jtm1816/georgia-esp32-scoreboard/docs/board-dimensions.png

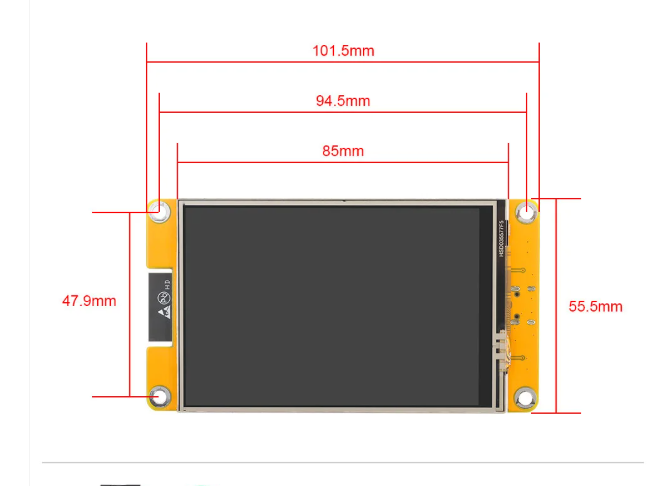
docs/board-dimensions.png
