jtm1816/georgia-esp32-scoreboard/case/front-bezel-with-lettering.stl

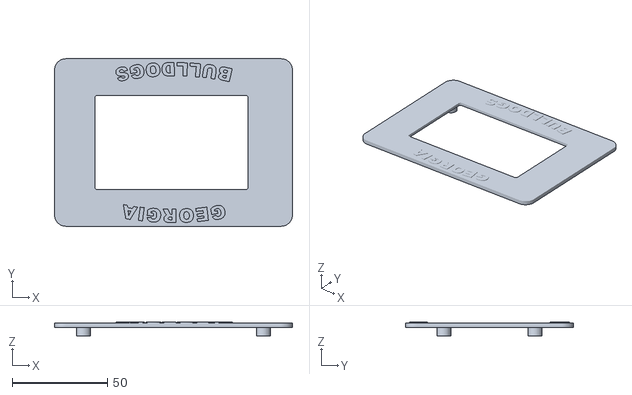
[picture p4: CAD file, 2026-11-13]
case/front-bezel-with-lettering.stl
125.0 x 88.0 x 7.40
