jtm1816/georgia-esp32-scoreboard/case/rear-shell-and-stand.stl

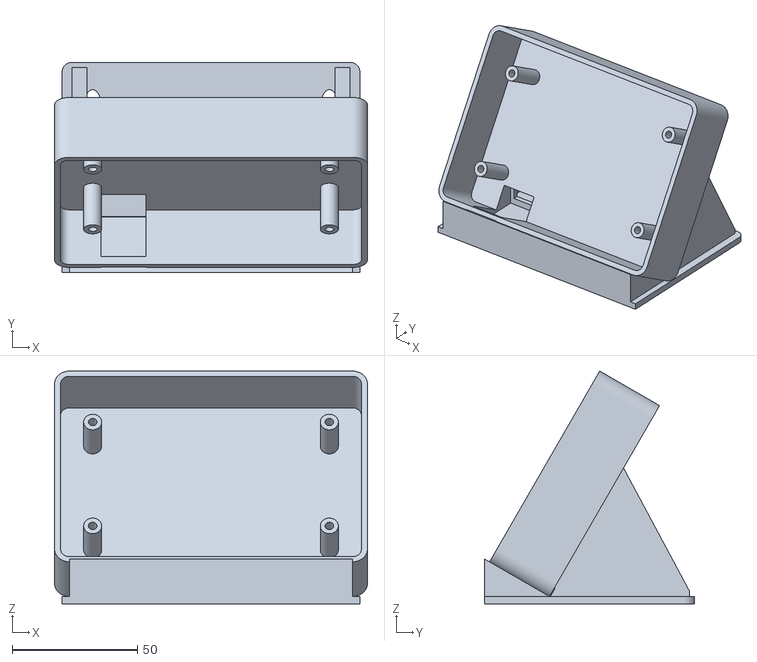
[picture p5: CAD file, 2026-11-10]
case/rear-shell-and-stand.stl
125.0 x 84.0 x 93.0
