jtm1816/georgia-esp32-scoreboard/docs/build-verification.txt

0900.250804 (4.9.0) 
 - toolchain-xtensa-esp32 @ 8.4.0+2021r2-patch5
LDF: Library Dependency Finder -> https://bit.ly/configure-pio-ldf
LDF Modes: Finder ~ chain, Compatibility ~ soft
Found 37 compatible libraries
Scanning dependencies...
Dependency Graph
|-- TFT_eSPI @ 2.5.43
|-- XPT2046_Touchscreen @ 0.0.0+sha.d57f64c
|-- ArduinoJson @ 7.4.2
|-- WiFiManager @ 2.0.17
|-- HTTPClient @ 2.0.0
|-- Preferences @ 2.0.0
|-- WiFi @ 2.0.0
|-- WiFiClientSecure @ 2.0.0
Building in release mode
Compiling .pio\build\esp32_035\src\main.cpp.o
In file included from src/main.cpp:7:
.pio/libdeps/esp32_035/TFT_eSPI/TFT_eSPI.h:973:8: warning: #warning >>>>------>> TOUCH_CS pin not defined, TFT_eSPI touch functions will not be available! [-Wcpp]
       #warning >>>>------>> TOUCH_CS pin not defined, TFT_eSPI touch functions will not be available!
        ^~~~~~~
Linking .pio\build\esp32_035\firmware.elf
Retrieving maximum program size .pio\build\esp32_035\firmware.elf
Checking size .pio\build\esp32_035\firmware.elf
Advanced Memory Usage is available via "PlatformIO Home > Project Inspect"
RAM:   [==        ]  15.5% (used 50768 bytes from 327680 bytes)
Flash: [======    ]  58.8% (used 1155969 bytes from 1966080 bytes)
Building .pio\build\esp32_035\firmware.bin with action:
  "$PYTHONEXE" "$OBJCOPY" --chip esp32 elf2image --flash_mode ${__get_board_flash_mode(__env__)} --flash_freq ${__get_board_f_image(__env__)} --flash_size 4MB --elf-sha256-offset 0xb0 -o $TARGET $SOURCES
Building .pio\build\esp32_035\firmware.bin
esptool.py v4.9.0
Creating esp32 image...
Merged 27 ELF sections
Successfully created esp32 image.
========================= [SUCCESS] Took 19.44 seconds =========================
