jtm1816/georgia-esp32-scoreboard/src/main.cpp

#include <Arduino.h>
#include <WiFi.h>
#include <WiFiClientSecure.h>
#include <HTTPClient.h>
#include <WiFiManager.h>
#include <Preferences.h>
#include <TFT_eSPI.h>
#include <XPT2046_Touchscreen.h>
#include <ArduinoJson.h>
#include <time.h>
#include <algorithm>
#include <vector>
#include <functional>
#include "georgia_logo.h"
#include "feed_ca.h"

// ESP32-035: 480x320 TFT and XPT2046 on the same HSPI bus.
// A fixed 16-color palette keeps the 480x320 frame at 76,800 bytes.
constexpr uint16_t BG=0,WHITE=1,DAWGS_RED=2,MUTED=3,GOLD=4;
const uint16_t PALETTE[16]={0x0841,0xffff,0xb865,0xbdf7,0xf66c,0xa285,0xfbe0,0x4208,0xf34c,0x2104,0x0000,0x8000,0xc800,0xf000,0x8410,0xd6ba};
const char* PATHS[]={"football/college-football","basketball/mens-college-basketball","baseball/college-baseball"};
const char* TITLES[]={"FOOTBALL","MEN'S BASKETBALL","BASEBALL"};
const char* IDS[]={"61","61","78"};
TFT_eSPI tft;
TFT_eSprite screen(&tft);
XPT2046_Touchscreen touch(33,36);
constexpr int DISPLAY_W=480,DISPLAY_H=320;
int calX1=300,calY1=300,calX2=3700,calY2=3700;
Preferences prefs;
SemaphoreHandle_t modelMutex;
volatile int selectedSport=0;
volatile bool manualSport=false, forceRefresh=true;
volatile uint32_t revision=0;
String serialLine;
bool scheduleView=false;
uint32_t scheduleUntil=0, viewSince=0;

void configurePanel(){
  pinMode(33,OUTPUT);digitalWrite(33,HIGH);
  tft.init();tft.setRotation(3);tft.invertDisplay(prefs.getBool("035inv",false));
  pinMode(27,OUTPUT);digitalWrite(27,HIGH);tft.fillScreen(BG);
  Serial.printf("PANEL ESP32-035 %dx%d ID04=%08lx IDD3=%08lx\n",tft.width(),tft.height(),tft.readcommand32(0x04),tft.readcommand32(0xd3));
}
void present(){screen.pushSprite(0,0);}
void drawLogo(int x,int y){
  for(int py=0;py<32;py++)for(int px=0;px<46;px++){
    uint16_t value=pgm_read_word(GEORGIA_LOGO+py*46+px);int best=0,bestDistance=INT_MAX;
    for(int i=0;i<16;i++){
      int dr=int((value>>11)&31)-int((PALETTE[i]>>11)&31);
      int dg=int((value>>5)&63)-int((PALETTE[i]>>5)&63);
      int db=int(value&31)-int(PALETTE[i]&31);int distance=dr*dr*4+dg*dg+db*db*4;
      if(distance<bestDistance){bestDistance=distance;best=i;}
    }
    screen.drawPixel(x+px,y+py,best);
  }
}

class CooperativeStream:public Stream{
  Stream& input;uint32_t bytes=0;
public:
  explicit CooperativeStream(Stream& s):input(s){setTimeout(20000);}
  int available()override{return input.available();}
  int peek()override{uint32_t start=millis();int v;while((v=input.peek())<0&&millis()-start<15000)delay(1);return v;}
  void flush()override{}
  size_t write(uint8_t)override{return 0;}
  int read()override{
    uint32_t start=millis();int v;
    while((v=input.read())<0&&millis()-start<15000)delay(1);
    if((++bytes&511)==0)delay(1);
    return v;
  }
};

struct Upcoming { String opponent,date,venue,city; bool home=false,neutral=false,tbd=false; };
struct Game {
  String id, date, opponent="OPPONENT", venue, city, state="", status="Loading...", detail;
  String lastPlay="Waiting for game data", score[2]={"-","-"}, bonus[2];
  String homeId, awayId;
  int timeouts[2]={-1,-1}, timeoutSlots=3, possession=-1, balls=-1,strikes=-1,outs=-1;
  bool first=false,second=false,third=false, live=false, loaded=false, error=false;
  uint32_t updated=0;
  Upcoming next[3]; int nextCount=0;
};
Game models[3];

String str(JsonVariantConst v, const char* fallback="") {
  if(v.is<const char*>()) return String(v.as<const char*>());
  if(v.is<int>()) return String(v.as<int>());
  if(v.is<float>()) return String(v.as<float>(),0);
  return String(fallback);
}
String ascii(String s) {
  s.replace("’","'"); s.replace("–","-"); s.replace("—","-"); s.replace("•","|");
  String out; out.reserve(s.length());
  for(size_t i=0;i<s.length();i++) if((uint8_t)s[i]>=32&&(uint8_t)s[i]<127) out+=s[i];
  return out;
}
time_t epoch(String iso) {
  int y,m,d,h=0,min=0;
  if(sscanf(iso.c_str(),"%d-%d-%dT%d:%d",&y,&m,&d,&h,&min)<3) return 0;
  y-=m<=2;int era=(y>=0?y:y-399)/400;unsigned yoe=y-era*400;
  unsigned doy=(153*(m+(m>2?-3:9))+2)/5+d-1;
  unsigned doe=yoe*365+yoe/4-yoe/100+doy;
  return (int64_t(era)*146097+doe-719468)*86400+h*3600+min*60;
}
String localDate(String iso,bool tbd=false) {
  time_t ts=epoch(iso); if(!ts) return "Date TBD";
  struct tm t;localtime_r(&ts,&t);char buf[48];
  strftime(buf,sizeof(buf),tbd?"%a %b %d | TBD":"%a %b %d | %I:%M %p ET",&t);
  return String(buf);
}

bool getJson(const String& url, JsonDocument& output, JsonDocument& filter) {
  WiFiClientSecure tls;tls.setCACert(FEED_CA);tls.setTimeout(15);
  HTTPClient http; http.useHTTP10(true);http.setConnectTimeout(12000);http.setTimeout(15000);
  if(!http.begin(tls,url)) return false;
  http.addHeader("Accept","application/json");http.addHeader("User-Agent","GeorgiaDeskDashboard/1.0");
  http.addHeader("Accept-Encoding","identity");
  int code=http.GET();
  if(code!=200){Serial.printf("FEED_HTTP %d\n",code);http.end();return false;}
  CooperativeStream response(http.getStream());
  auto err=deserializeJson(output,response,DeserializationOption::Filter(filter),DeserializationOption::NestingLimit(40));
  http.end();
  if(err){Serial.printf("FEED_JSON %s\n",err.c_str());return false;}
  return true;
}

// Parse a large feed array incrementally; never retain a whole day's games.
bool walkArray(const String& url,const char* key,JsonDocument& filter,std::function<bool(JsonVariantConst)> visit){
  WiFiClientSecure tls;tls.setCACert(FEED_CA);tls.setTimeout(20);
  HTTPClient http;http.useHTTP10(true);http.setConnectTimeout(12000);http.setTimeout(20000);
  if(!http.begin(tls,url))return false;
  http.addHeader("Accept-Encoding","identity");http.addHeader("User-Agent","GeorgiaDeskDashboard/1.1");
  int code=http.GET();if(code!=200){Serial.printf("ARRAY_HTTP %d\n",code);http.end();return false;}
  CooperativeStream stream(http.getStream());String token=String("\"")+key+"\"";
  if(!stream.find(token.c_str())||!stream.find("[")){http.end();return false;}
  bool ok=true;JsonDocument item;
  for(;;){
    int ch=stream.peek();while(ch==' '||ch=='\r'||ch=='\n'||ch=='\t'||ch==','){stream.read();ch=stream.peek();}
    if(ch==']')break;
    if(ch!='{'){ok=false;break;}
    auto err=deserializeJson(item,stream,DeserializationOption::Filter(filter),DeserializationOption::NestingLimit(40));
    if(err){Serial.printf("ARRAY_JSON %s\n",err.c_str());ok=false;break;}
    if(!visit(item.as<JsonVariantConst>()))break;
    item.clear();delay(1);
  }
  http.end();return ok;
}

void eventFilter(JsonObject v) {
  v["id"]=true;v["date"]=true;v["status"]=true;
  JsonObject c=v["competitions"][0].to<JsonObject>();c["id"]=true;c["date"]=true;c["dateValid"]=true;
  c["status"]=true;c["venue"]=true;c["neutralSite"]=true;c["situation"]=true;
  JsonObject t=c["competitors"][0].to<JsonObject>();
  t["id"]=true;t["homeAway"]=true;t["score"]=true;t["possession"]=true;
  t["timeoutsRemaining"]=true;t["bonus"]=true;t["doubleBonus"]=true;
  t["team"]["id"]=true;t["team"]["shortDisplayName"]=true;
  t["team"]["displayName"]=true;t["team"]["abbreviation"]=true;
}
void location(JsonVariantConst venue, String& name,String& city) {
  name=ascii(str(venue["fullName"]));
  city=ascii(str(venue["address"]["city"]));
  String region=str(venue["address"]["state"]);
  if(region.length())city+=(city.length()?", ":"")+region;
}
int teamIndex(String id,int sport) {return id==IDS[sport]?0:1;}
void readEvent(JsonVariantConst e,Game& g,int sport) {
  auto c=e["competitions"][0];
  g.id=str(e["id"]);g.date=str(e["date"]);
  auto status=e["status"].isNull()?c["status"]:e["status"];
  g.state=str(status["type"]["state"]);g.live=g.state=="in";
  g.status=ascii(str(status["type"]["shortDetail"],"Scheduled"));
  if(g.state=="pre")g.status=localDate(g.date,c["dateValid"]==false);
  location(c["venue"],g.venue,g.city);
  g.possession=-1;g.timeouts[0]=g.timeouts[1]=-1;g.bonus[0]=g.bonus[1]="";
  g.balls=g.strikes=g.outs=-1;g.first=g.second=g.third=false;
  g.timeoutSlots=sport==0?3:4;
  for(auto t:c["competitors"].as<JsonArrayConst>()) {
    String id=str(t["id"]);if(!id.length())id=str(t["team"]["id"]);
    int n=teamIndex(id,sport);
    if(n==1)g.opponent=ascii(str(t["team"]["shortDisplayName"],str(t["team"]["displayName"],"Opponent").c_str()));
    if(str(t["homeAway"])=="home")g.homeId=id;else g.awayId=id;
    g.score[n]=str(t["score"]["displayValue"]);
    if(!g.score[n].length())g.score[n]=str(t["score"],"-");
    if(g.state=="pre")g.score[n]="-";
    if(g.live&&t["possession"]==true)g.possession=n;
    if(g.live&&t["timeoutsRemaining"].is<int>())g.timeouts[n]=t["timeoutsRemaining"];
    if(g.live&&t["doubleBonus"]==true)g.bonus[n]="DOUBLE BONUS";
    else if(g.live&&t["bonus"]==true)g.bonus[n]="BONUS";
  }
  auto sit=c["situation"];
  g.detail=ascii(str(sit["downDistanceText"]));
  if(g.live&&!sit.isNull()) {
    String poss=str(sit["possession"]);
    if(poss.length())g.possession=teamIndex(poss,sport);
    if(sport==2){
      if(sit["balls"].is<int>())g.balls=sit["balls"];
      if(sit["strikes"].is<int>())g.strikes=sit["strikes"];
      if(sit["outs"].is<int>())g.outs=sit["outs"];
      g.first=sit["onFirst"]|false;g.second=sit["onSecond"]|false;g.third=sit["onThird"]|false;
      String prefix=str(status["periodPrefix"]);String low=g.status;low.toLowerCase();
      if(g.possession<0&&(prefix=="Top"||low.indexOf("top")>=0))g.possession=teamIndex(g.awayId,sport);
      if(g.possession<0&&(prefix=="Bottom"||low.indexOf("bot")>=0))g.possession=teamIndex(g.homeId,sport);
      g.detail=g.first||g.second||g.third?String(g.first?"1B ":"")+String(g.second?"2B ":"")+String(g.third?"3B ":"")+"occupied":"Bases empty";
    }
  }
  g.loaded=true;
}

bool fetchSchedule(int sport,Game& result) {
  JsonDocument filter;eventFilter(filter.to<JsonObject>());
  String url=String("https://site.api.espn.com/apis/site/v2/sports/")+PATHS[sport]+"/teams/"+IDS[sport]+"/schedule";
  time_t now=time(nullptr),lastTime=0,soon=LONG_MAX;Game live,last,upcoming;bool haveLive=false,haveLast=false,haveNext=false;int count=0;
  std::vector<Upcoming> next;
  auto visitor=[&](JsonVariantConst e){
    count++;
    auto c=e["competitions"][0];auto st=e["status"].isNull()?c["status"]:e["status"];
    String state=str(st["type"]["state"]);time_t ts=epoch(str(e["date"]));
    if(state=="in"){readEvent(e,live,sport);haveLive=true;}
    if(state=="post"&&ts>lastTime){lastTime=ts;readEvent(e,last,sport);haveLast=true;}
    if(state=="pre"&&ts>now-86400){
      Game temp;readEvent(e,temp,sport);if(ts<soon){soon=ts;upcoming=temp;haveNext=true;}
      Upcoming u;u.date=temp.date;u.opponent=temp.opponent;u.venue=temp.venue;u.city=temp.city;
      u.tbd=c["dateValid"]==false;u.neutral=c["neutralSite"]|false;
      u.home=temp.homeId==IDS[sport];next.push_back(u);
      std::sort(next.begin(),next.end(),[](const Upcoming& a,const Upcoming& b){return a.date<b.date;});
      if(next.size()>3)next.pop_back();
    }
    return true;
  };
  if(!walkArray(url,"events",filter,visitor))return false;
  if(!count){struct tm t;localtime_r(&now,&t);String season=String(t.tm_year+1900+(sport==1&&t.tm_mon>=6?1:0));if(!walkArray(url+"?season="+season,"events",filter,visitor))return false;}
  String previousId=result.id,previousPlay=result.lastPlay;
  if(haveLive)result=live;else if(haveLast&&now-lastTime<18*3600)result=last;else if(haveNext)result=upcoming;else if(haveLast)result=last;
  else {result=Game();result.loaded=true;result.status="Schedule unavailable";result.lastPlay="No published games found";}
  if(result.id==previousId&&previousId.length())result.lastPlay=previousPlay;
  result.nextCount=next.size();for(int i=0;i<result.nextCount;i++)result.next[i]=next[i];
  return true;
}
String latestPlay(JsonVariantConst plays) {
  String found;
  for(auto p:plays.as<JsonArrayConst>()){
    String txt=ascii(str(p["text"]));String low=txt;low.toLowerCase();
    if(txt.length()&&low.indexOf("end of")==-1&&low!="end game")found=txt;
  }
  return found;
}
void summaryFilter(JsonDocument& f) {
  f["gameInfo"]["venue"]=true;
  JsonObject p=f["plays"][0].to<JsonObject>();p["text"]=true;p["type"]=true;p["team"]["id"]=true;
  p["participants"][0]["athlete"]["displayName"]=true;
  f["drives"]["current"]["plays"][0]["text"]=true;
  f["drives"]["previous"][0]["plays"][0]["text"]=true;
  f["atBats"][0]["text"]=true;
}
String timeoutLabel(String text,String teamId,Game& g,int sport){
  String low=text;low.toLowerCase();
  if(low.indexOf("timeout")<0&&low.indexOf("time out")<0)return text;
  if(low.indexOf("media")>=0||low.indexOf("official")>=0||low.indexOf("tv timeout")>=0)return "TIMEOUT - OFFICIAL";
  if(teamId.length())return "TIMEOUT - "+(teamIndex(teamId,sport)==0?String("GEORGIA"):g.opponent);
  String opp=g.opponent;opp.toLowerCase();
  if(low.indexOf("georgia")>=0||low.indexOf("uga")>=0)return "TIMEOUT - GEORGIA";
  if(opp.length()&&low.indexOf(opp)>=0)return "TIMEOUT - "+g.opponent;
  return "TIMEOUT";
}
bool fetchSummary(int sport,Game& g) {
  if(!g.id.length()||g.state=="pre"){g.lastPlay=g.state=="pre"?"Game has not started":"Play-by-play unavailable";return true;}
  JsonDocument f,doc;summaryFilter(f);
  String url=String("https://site.api.espn.com/apis/site/v2/sports/")+PATHS[sport]+"/summary?event="+g.id;
  if(sport==1){
    JsonDocument pf;pf["text"]=true;pf["team"]["id"]=true;
    String latest,team;
    bool ok=walkArray(url,"plays",pf,[&](JsonVariantConst p){String s=ascii(str(p["text"]));String low=s;low.toLowerCase();if(s.length()&&low.indexOf("end of")==-1){latest=s;team=str(p["team"]["id"]);}return true;});
    if(ok)g.lastPlay=latest.length()?timeoutLabel(latest,team,g,sport):"Play-by-play unavailable";
    return ok;
  }
  if(!getJson(url,doc,f))return false;
  if(!doc["gameInfo"]["venue"].isNull())location(doc["gameInfo"]["venue"],g.venue,g.city);
  String text=latestPlay(doc["plays"]),team;
  JsonVariantConst lastRelevant;
  for(auto p:doc["plays"].as<JsonArrayConst>())if(ascii(str(p["text"]))==text)lastRelevant=p;
  if(!lastRelevant.isNull())team=str(lastRelevant["team"]["id"]);
  if(!text.length())for(auto drive:doc["drives"]["previous"].as<JsonArrayConst>()){String s=latestPlay(drive["plays"]);if(s.length())text=s;}
  String current=latestPlay(doc["drives"]["current"]["plays"]);if(current.length())text=current;
  if(!text.length())text=latestPlay(doc["atBats"]);
  g.lastPlay=text.length()?timeoutLabel(text,team,g,sport):"Play-by-play unavailable";
  return true;
}
bool scoreboard(int sport,Game& g,bool& foundLive) {
  JsonDocument f;eventFilter(f.to<JsonObject>());
  time_t now=time(nullptr);struct tm t;localtime_r(&now,&t);char date[10];strftime(date,sizeof(date),"%Y%m%d",&t);
  String url=String("https://site.api.espn.com/apis/site/v2/sports/")+PATHS[sport]+"/scoreboard?limit=1000&dates="+date+(sport==0?"&groups=80":sport==1?"&groups=50":"");
  foundLive=false;
  return walkArray(url,"events",f,[&](JsonVariantConst e){
    bool uga=false;for(auto c:e["competitions"][0]["competitors"].as<JsonArrayConst>())if(str(c["id"])==IDS[sport])uga=true;
    if(!uga)return true;
    String state=str(e["status"]["type"]["state"]);
    if(state=="in"||str(e["id"])==g.id||state=="post"){
      readEvent(e,g,sport);foundLive=g.live;
      if(!e["competitions"][0]["situation"]["lastPlay"]["text"].isNull())
        g.lastPlay=timeoutLabel(ascii(str(e["competitions"][0]["situation"]["lastPlay"]["text"])),str(e["competitions"][0]["situation"]["lastPlay"]["team"]["id"]),g,sport);
      if(foundLive)return false;
    }
    return true;
  });
}
Game snapshot(int sport){xSemaphoreTake(modelMutex,portMAX_DELAY);Game g=models[sport];xSemaphoreGive(modelMutex);return g;}
void publish(int sport,const Game& g){xSemaphoreTake(modelMutex,portMAX_DELAY);models[sport]=g;revision++;xSemaphoreGive(modelMutex);}
void feedTask(void*){
  uint32_t scheduleAt[3]={},boardAt[3]={};int lastSelected=-1;
  for(;;){
    if(WiFi.status()!=WL_CONNECTED){vTaskDelay(pdMS_TO_TICKS(1000));continue;}
    if(time(nullptr)<1700000000){vTaskDelay(pdMS_TO_TICKS(1000));continue;}
    int active=selectedSport;bool force=forceRefresh||lastSelected!=active;forceRefresh=false;lastSelected=active;
    int livePriority=-1;
    for(int s=0;s<3;s++){
      Game g=snapshot(s);uint32_t now=millis();bool ok=true;
      if(!g.loaded||now-scheduleAt[s]>900000){ok=fetchSchedule(s,g);scheduleAt[s]=now;}
      if(now-boardAt[s]>(s==active?30000:90000)||boardAt[s]==0||(force&&s==active)){
        bool isLive=false;bool b=scoreboard(s,g,isLive);ok=ok&&b;boardAt[s]=millis();
        if(s==active){String existing=g.lastPlay;if(!fetchSummary(s,g)){ok=false;g.lastPlay=existing;}}
        if(ok){g.updated=millis();g.error=false;}else g.error=true;
        publish(s,g);
        Serial.printf("SPORT %d state=%s score=%s-%s feed=%s heap=%u\n",s,g.state.c_str(),g.score[0].c_str(),g.score[1].c_str(),ok?"OK":"ERROR",ESP.getFreeHeap());
      }else if(!ok){g.error=true;publish(s,g);}
      if(g.live&&livePriority<0)livePriority=s;
      vTaskDelay(pdMS_TO_TICKS(150));
    }
    if(!manualSport&&livePriority>=0&&selectedSport!=livePriority){selectedSport=livePriority;forceRefresh=true;}
    vTaskDelay(pdMS_TO_TICKS(800));
  }
}

void text(String s,int x,int y,int font=2,uint16_t color=WHITE){screen.setTextColor(color,BG);screen.drawString(ascii(s),x,y,font);}
void centered(String s,int y,int font=2,uint16_t color=WHITE){screen.setTextColor(color,BG);screen.drawCentreString(ascii(s),240,y,font);}
void moving(String s,int x,int y,int width,int font,uint16_t color,uint32_t since){
  s=ascii(s);screen.setTextColor(color,BG);int tw=screen.textWidth(s,font);
  screen.setViewport(x,y,width,screen.fontHeight(font));
  uint32_t age=millis()-since;int offset=tw>width&&age>1800?((age-1800)/45)%(tw+width):0;
  screen.drawString(s,-offset,0,font);if(offset>0)screen.drawString(s,tw+width-offset,0,font);
  screen.resetViewport();
}
void ballIcon(int sport,int x,int y){
  if(sport==0){screen.fillEllipse(x,y,10,6,5);screen.drawLine(x-5,y,x+5,y,WHITE);for(int a=-3;a<=3;a+=3)screen.drawLine(x+a,y-2,x+a,y+2,WHITE);}
  else if(sport==1){screen.fillCircle(x,y,8,6);screen.drawCircle(x,y,8,BG);screen.drawLine(x-8,y,x+8,y,BG);screen.drawLine(x,y-8,x,y+8,BG);screen.drawEllipse(x,y,4,8,BG);}
  else{screen.fillCircle(x,y,8,WHITE);screen.drawLine(x-5,y-5,x-3,y+5,DAWGS_RED);screen.drawLine(x+5,y-5,x+3,y+5,DAWGS_RED);}
}
void drawTeam(const Game& g,int team,int y,int sport,bool fresh){
  String name=team==0?"GEORGIA":g.opponent;name.toUpperCase();
  while(screen.textWidth(name,4)>270&&name.length()>1)name.remove(name.length()-1);
  text(name,44,y,4,team==0?WHITE:MUTED);
  if(fresh&&g.live&&g.possession==team)ballIcon(sport,21,y+13);
  if(fresh&&g.timeouts[team]>=0&&sport<2){int tx=std::min(322,52+screen.textWidth(name,4));
    for(int i=0;i<g.timeoutSlots;i++)screen.fillCircle(tx+i*9,y+10,3,i<g.timeouts[team]?WHITE:7);}
  if(sport==1&&fresh&&g.bonus[team].length())text(g.bonus[team],44,y+28,1,GOLD);
  screen.setTextColor(WHITE,BG);screen.drawRightString(g.score[team],465,y-2,6);
}
void countRow(const Game& g,int y,bool fresh){
  String b=fresh&&g.balls>=0?String(g.balls):"-";
  String s=fresh&&g.strikes>=0?String(g.strikes):"-";
  String o=fresh&&g.outs>=0?String(g.outs):"-";
  text("Balls "+b,44,y,1,MUTED);text("Strikes "+s,152,y,1,MUTED);text("Outs "+o,270,y,1,MUTED);
}
void draw(){
  int sport=selectedSport;Game g=snapshot(sport);screen.fillSprite(BG);
  screen.fillRect(0,0,480,56,DAWGS_RED);drawLogo(12,12);
  screen.setTextColor(WHITE,DAWGS_RED);screen.drawString("GEORGIA BULLDOGS",76,4,4);screen.drawString(String(TITLES[sport])+" >",76,36,2);
  bool fresh=g.updated&&millis()-g.updated<120000&&WiFi.status()==WL_CONNECTED&&!g.error;
  screen.drawRightString(scheduleView?"NEXT":g.live&&fresh?"LIVE":g.state=="post"?"FINAL":"",468,37,1);
  if(scheduleView){
    text("NEXT 3 GAMES",12,62,2);text(String(std::max(1,(int)((scheduleUntil-millis()+999)/1000)))+"s",450,62,2,MUTED);
    for(int i=0;i<g.nextCount;i++){
      auto u=g.next[i];int y=90+i*68;
      moving(String(u.neutral?"vs ":u.home?"vs ":"at ")+u.opponent,12,y,456,2,WHITE,viewSince);
      text(localDate(u.date,u.tbd),12,y+19,1,MUTED);
      moving(u.venue+(u.city.length()?" | "+u.city:""),12,y+32,456,1,MUTED,viewSince);
    }
    if(!g.nextCount)centered(g.loaded?"No published upcoming games":"Loading schedule...",128,2);
  }else{
    moving(g.status,12,62,280,2,MUTED,viewSince);
    moving(g.detail,300,65,168,1,MUTED,viewSince);
    int y0=96,y1=160;
    drawTeam(g,0,y0,sport,fresh);
    if(sport==2&&g.possession==0)countRow(g,y0+31,fresh);
    drawTeam(g,1,y1,sport,fresh);
    if(sport==2&&g.possession==1)countRow(g,y1+31,fresh);
    if(sport==2&&g.possession<0&&g.live)countRow(g,211,false);
    String venue=g.venue;if(g.city.length())venue+=(venue.length()?" | ":"")+g.city;
    moving(venue.length()?venue:"Location not published",12,230,456,1,MUTED,viewSince);
    screen.drawFastHLine(12,248,456,7);text("LAST PLAY",12,254,1,8);
    moving(g.lastPlay,12,272,456,2,WHITE,viewSince);
  }
  screen.fillRect(0,302,480,18,9);screen.setTextColor(MUTED,9);
  String footer;
  if(WiFi.status()!=WL_CONNECTED)footer="Wi-Fi reconnecting...";
  else if(!g.loaded)footer="Wi-Fi connected | Loading scores...";
  else if(!g.updated||g.error)footer="Feed unavailable | Retrying...";
  else if(!fresh)footer="STALE | Last update "+String((millis()-g.updated)/1000)+"s ago";
  else footer="Wi-Fi | Updated "+String((millis()-g.updated)/1000)+"s ago";
  screen.drawString(footer,10,307,1);screen.drawRightString("ET",468,307,1);
  present();
}

void splash(String title,String line){screen.fillSprite(BG);centered(title,57,2);centered(line,92,2,MUTED);present();}
bool processSerial(){
  while(Serial.available()){
    char c=Serial.read();if(c=='\r')continue;
    if(c=='\n'){
      if(serialLine.startsWith("WIFI ")){
        JsonDocument d;auto err=deserializeJson(d,serialLine.substring(5));
        if(!err&&d["ssid"].is<const char*>()&&d["password"].is<const char*>()){
          prefs.putString("ssid",d["ssid"].as<String>());prefs.putString("pass",d["password"].as<String>());
          serialLine="";Serial.println("WIFI_SAVED");return true;
        }
      }else if(serialLine=="STATUS")Serial.printf("STATUS wifi=%d ip=%s heap=%u sport=%d panel=ESP32-035 480x320\n",WiFi.status(),WiFi.localIP().toString().c_str(),ESP.getFreeHeap(),selectedSport);
      else if(serialLine=="CALIBRATE")prefs.putBool("035cal",true);
      else if(serialLine.startsWith("INVERT ")){prefs.putBool("035inv",serialLine.endsWith("1"));configurePanel();}
      serialLine="";
    }else if(serialLine.length()<256)serialLine+=c;else serialLine="";
  }return false;
}
void calibrate(){
  int values[4];const int xs[]={20,460},ys[]={20,300};
  for(int i=0;i<2;i++){
    screen.fillSprite(BG);centered("TOUCH SETUP",125,2);centered("Press the cross firmly",150,2,MUTED);
    screen.drawFastHLine(xs[i]-10,ys[i],21,WHITE);screen.drawFastVLine(xs[i],ys[i]-10,21,WHITE);present();
    uint32_t deadline=millis()+45000;
    while(touch.touched()&&(int32_t)(deadline-millis())>0)delay(10);
    delay(150);int64_t sx=0,sy=0;int n=0;
    while(n<12&&(int32_t)(deadline-millis())>0){
      if(touch.touched()){auto p=touch.getPoint();if(p.z>200){sx+=p.x;sy+=p.y;n++;}}delay(15);
    }
    if(n<12){Serial.println("TOUCH_CALIBRATION_TIMEOUT");return;}
    values[i*2]=sx/n;values[i*2+1]=sy/n;
  }
  // Store calibration in the original touch orientation, independent of display flip.
  std::swap(values[0],values[2]);std::swap(values[1],values[3]);
  if(abs(values[2]-values[0])<500||abs(values[3]-values[1])<500){Serial.println("TOUCH_CALIBRATION_REJECTED");return;}
  calX1=values[0]-(values[2]-values[0])*20/440;calX2=values[2]+(values[2]-values[0])*19/440;
  calY1=values[1]-(values[3]-values[1])*20/280;calY2=values[3]+(values[3]-values[1])*19/280;
  prefs.putInt("035x1",calX1);prefs.putInt("035x2",calX2);prefs.putInt("035y1",calY1);prefs.putInt("035y2",calY2);
  prefs.putBool("035cal",false);Serial.println("TOUCH_CALIBRATED");
}
void setup(){
  Serial.begin(115200);pinMode(0,INPUT_PULLUP);
  prefs.begin("dawgs",false);configurePanel();
  screen.setColorDepth(4);
  if(!screen.createSprite(DISPLAY_W,DISPLAY_H)){Serial.println("DISPLAY_MEMORY_ERROR");for(;;)delay(1000);}
  screen.createPalette(PALETTE,16);
  // Share TFT_eSPI's exact SPI instance; no second bus is reconfigured.
  // Keep touch raw orientation stable so saved calibration remains valid.
  touch.begin(TFT_eSPI::getSPIinstance());touch.setRotation(1);
  for(int pin:{4,16,17}){pinMode(pin,OUTPUT);digitalWrite(pin,HIGH);}
  calX1=prefs.getInt("035x1",300);calX2=prefs.getInt("035x2",3700);
  calY1=prefs.getInt("035y1",300);calY2=prefs.getInt("035y2",3700);
  modelMutex=xSemaphoreCreateMutex();
  splash("GEORGIA BULLDOGS","Configuring Wi-Fi...");Serial.println("READY_CONFIG");
  uint32_t start=millis();uint32_t wait=prefs.getString("ssid").length()?2500:45000;
  while(millis()-start<wait){if(processSerial())break;delay(10);}
  WiFi.mode(WIFI_STA);WiFi.setSleep(false);WiFi.setAutoReconnect(true);
  String ssid=prefs.getString("ssid"),pass=prefs.getString("pass");
  if(ssid.length())WiFi.begin(ssid.c_str(),pass.c_str());else WiFi.begin();
  splash("GEORGIA BULLDOGS","Connecting to Wi-Fi...");start=millis();
  while(WiFi.status()!=WL_CONNECTED&&millis()-start<25000){if(processSerial()){ssid=prefs.getString("ssid");pass=prefs.getString("pass");WiFi.begin(ssid.c_str(),pass.c_str());}delay(50);}
  if(WiFi.status()!=WL_CONNECTED){
    splash("Join Wi-Fi: Dawgs-Setup","Password: GoDawgs!");
    Serial.println("WIFI_PORTAL Dawgs-Setup http://192.168.4.1");
    WiFiManager wm;wm.setDebugOutput(false);wm.setConfigPortalTimeout(180);wm.setBreakAfterConfig(true);
    wm.startConfigPortal("Dawgs-Setup","GoDawgs!");
  }
  Serial.printf("WIFI_CONNECTED %d IP %s\n",WiFi.status()==WL_CONNECTED,WiFi.localIP().toString().c_str());
  configTzTime("EST5EDT,M3.2.0/2,M11.1.0/2","pool.ntp.org","time.nist.gov");
  if(!prefs.isKey("035x1")||prefs.getBool("035cal",false))calibrate();
  viewSince=millis();draw();xTaskCreatePinnedToCore(feedTask,"scores",24576,nullptr,1,nullptr,0);
  Serial.println("DASHBOARD_READY");
}
void loop(){
  static bool pressed=false;static uint32_t lastDraw=0,bootStart=0;static String previousPlay;static int previousSport=-1;
  if(processSerial()){WiFi.disconnect();String s=prefs.getString("ssid"),p=prefs.getString("pass");WiFi.begin(s.c_str(),p.c_str());}
  if(digitalRead(0)==LOW){if(!bootStart)bootStart=millis();if(millis()-bootStart>2500){calibrate();bootStart=0;pressed=true;}}else bootStart=0;
  bool nowPressed=touch.touched();
  if(nowPressed&&!pressed){auto p=touch.getPoint();if(p.z>200){int x=479-map(p.x,calX1,calX2,0,479),y=319-map(p.y,calY1,calY2,0,319);
    if(y>=0&&y<56){
      if(x>=0&&x<70){scheduleView=!scheduleView;scheduleUntil=millis()+7000;viewSince=millis();}
      else if(x>=70&&x<430){selectedSport=(selectedSport+1)%3;manualSport=true;forceRefresh=true;scheduleView=false;viewSince=millis();Serial.printf("SELECT_SPORT %d\n",selectedSport);}
    }
    pressed=true;
  }}
  if(!nowPressed)pressed=false;
  if(scheduleView&&(int32_t)(millis()-scheduleUntil)>=0){scheduleView=false;viewSince=millis();}
  if(millis()-lastDraw>180){Game g=snapshot(selectedSport);if(previousSport!=selectedSport||previousPlay!=g.lastPlay){viewSince=millis();previousSport=selectedSport;previousPlay=g.lastPlay;}draw();lastDraw=millis();}
  delay(10);
}
