jtm1816/georgia-esp32-scoreboard/include/georgia_logo.h

#pragma once
static const uint16_t GEORGIA_LOGO[46*32] PROGMEM = {
0xb865,0xb865,0xb865,0xb865,0xb865,0xb865,0xb865,0xb865,0xb865,0xb865,0xb865,0xb865,0xb865,0xb865,0xb865,0xb865,
0xb865,0xb865,0xb865,0xb865,0xb865,0xb865,0xb865,0xb865,0xb865,0xb865,0xb865,0xb865,0xb865,0xb865,0xb865,0xb865,
0xb865,0xb865,0xb865,0xb865,0xb865,0xb865,0xb865,0xb865,0xb865,0xb865,0xb865,0xb865,0xb865,0xb865,0xb865,0xb865,
0xb865,0xb865,0xb865,0xb865,0xb865,0xb865,0xb865,0xb865,0xb865,0xb865,0xb865,0xb865,0xb865,0xb045,0xb044,0xb023,
0xb024,0xb825,0xb886,0xc0a7,0xc0c7,0xc0c7,0xc0a7,0xb886,0xb825,0xb024,0xb023,0xb044,0xb045,0xb865,0xb865,0xb865,
0xb865,0xb865,0xb865,0xb865,0xb865,0xb865,0xb865,0xb865,0xb865,0xb865,0xb865,0xb865,0xb865,0xb865,0xb865,0xb865,
0xb865,0xb865,0xb865,0xb865,0xb865,0xb865,0xb865,0xb865,0xb044,0xb024,0xb886,0xc9cb,0xe350,0xf4b5,0xf577,0xf619,
0xee5a,0xe65a,0xe659,0xe659,0xe639,0xee39,0xf5d8,0xf557,0xf474,0xe32f,0xc9aa,0xb866,0xb024,0xb044,0xb865,0xb865,
0xb865,0xb865,0xb865,0xb865,0xb865,0xb865,0xb865,0xb865,0xb865,0xb865,0xb865,0xb865,0xb865,0xb865,0xb865,0xb865,
0xb865,0xb865,0xb865,0xb845,0xb023,0xb886,0xdace,0xfd37,0xf69b,0xd69a,0xadb6,0x8c91,0x6b8d,0x52ca,0x4248,0x39e7,
0x39e7,0x39e7,0x39e7,0x3a28,0x4a8a,0x636d,0x8471,0xad95,0xd659,0xf65a,0xfcf5,0xd26d,0xb845,0xb023,0xb845,0xb865,
0xb865,0xb865,0xb865,0xb865,0xb865,0xb865,0xb865,0xb865,0xb865,0xb865,0xb865,0xb865,0xb865,0xb865,0xb865,0xb845,
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
0x2965,0x20e3,0x6b2c,0xffff,0xffff,0xffff,0xffff,0xffff,0xffff,0xffff,0xffff,0xffff,0xffff,0xffff,0xffff,0xffff,
0xffff,0xffff,0xffff,0xffff,0xffff,0xffff,0xffff,0xffff,0xffff,0xffff,0xffff,0xffff,0xffff,0xffff,0xffff,0xffff,
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
};
