jtm1816/georgia-esp32-scoreboard/(commit log)

2026-10-25 Add Georgia ESP32 scoreboard firmware and illustrated overview
2026-10-25 Support display variants and stream game feeds within ESP32 memory
2026-10-25 Add Georgia desk case, print files, PETG guide, and overview section
    [front-bezel-red.stl, lettering-white.stl, rear-shell-black.stl, stand-black.stl]
2026-10-29 Port scoreboard and printable case to verified ESP32-035 hardware
    [front-bezel-red.stl, lettering-white.stl, rear-shell-black.stl, stand-black.stl]
2026-11-09 Fuse lettering and rear stand, relocate USB channel, and close stand front
    [front-bezel-red.stl, front-bezel-with-lettering.stl, lettering-white.stl, rear-shell-and-stand.stl, rear-shell-black.stl, stand-black.stl]
2026-11-09 Correct front lettering direction and match preview to printable orientation
    [front-bezel-with-lettering.stl, rear-shell-and-stand.stl]
2026-11-10 Rotate display 180 degrees and preserve calibrated touch alignment
2026-11-13 Correct bezel opening width and offset and reduce insert pilots to 4 mm
    [front-bezel-with-lettering.stl]
